avandalen/PCB-Spotwelder-Controller/README.md

This advanced controller was used by many people and has a unique reduced inrush current circuit that prevents main fuse blow up. This product is no longer for sale since 7-2020. 
See the article here: https://www.avdweb.nl/popular/spotwelder/spot-welder-controller-with-tft-display
