avandalen/PCB-Spotwelder-Controller/UPC v4.brd

## EAGLE design UPC v4.brd (2020-08-19, last stored version)

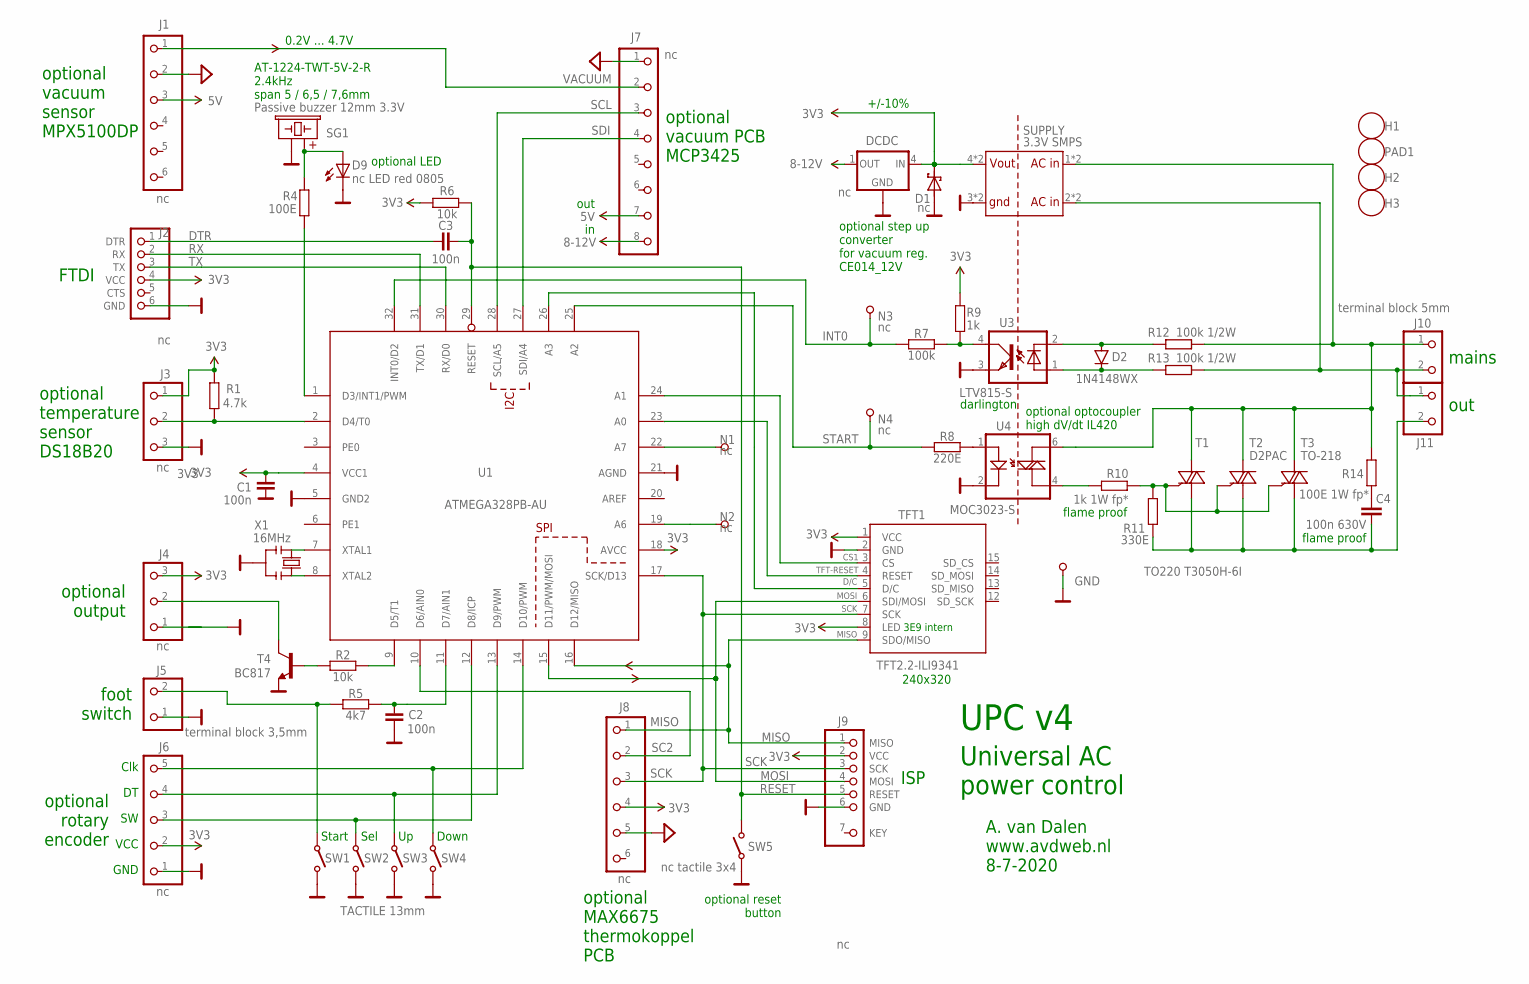
[picture p1: schematic UPC v4.sch]

Parts:
C1, C2, C3: 100n; 0603-SMALL
C4: 100n 630V; C15B6
D1: nc; DO-214AC
D2: 1N4148WX; SOD-323
D9: nc LED red 0805; CHIP-LED0805
DCDC: nc; 1X04-ACDC
GND: GND; PIN
H1, H2, H3: HOLE3.6; HOLE-3.6MM
J1: nc; MPX5100-VACUUM-SENSOR
J2: nc; ZIGZAG-FTDI
J3, J4: nc; 1X03
J5: terminal block 3,5mm; SCREWTERMINAL-3.5MM-2
J6: nc; 1X05
J7: nc; 1X08
J8: nc; 1X06-ISP-BOARD
J9: nc; ZIGZAG-ISP
J10: Terminal block 5mm 2p; SCREWTERMINAL-5MM-2
J11: terminal block 5mm; SCREWTERMINAL-5MM-2
N1, N2, N3, N4: nc; PIN-1.2MM
PAD1: HOLE3.6; HOLE-3.6MM
R1: 4.7k; 0603-SMALL
R2, R6: 10k; 0603-SMALL
R4: 100E; 0603-SMALL
R5: 4k7; 0603-SMALL
R7: 100k; 0603-SMALL
R8: 220E; 0603-SMALL
R9: 1k; 0603-SMALL
R10: 1k 1W fp*; 0411/15_AVD
R11: 330E; 0603-SMALL
R12, R13: 100k 1/2W; M1206
R14: 100E 1W fp*; 0411/15_AVD
SG1: Passive buzzer 12mm 3.3V; BUZZER-12MM-NS-KIT
SUPPLY: 3.3V SMPS; SMPS2
SW1, SW2, SW3, SW4: TACTILE 13mm; TACTILE-PTH
SW5: nc tactile 3x4; TACTILE-3X4
T1: TO220 T3050H-6I; TO220-SPOTWELDER
T2: D2PAC; D2PACK-SPOTWELDER-NO-CREAM
T3: TO-218; TO218-SPOTWELDER
T4: BC817; SOT23-3
TFT1: TFT2.2-ILI9341; TFT2.2-9P
U1: ATMEGA328PB-AU; TQFP32-08
U3: LTV815-S; DIL4-SMD
U4: MOC3023-S; DIL6-SMD-WIDE
X1: 16MHz; RESONATOR

Connections:
3V3: C1.2, D1.C, DCDC.4 (IN), J2.4 (VCC), J3.1, J4.3, J6.2, J8.4, J9.2 (VCC), R1.1, R6.2, R9.2, SUPPLY.4 (5V), SUPPLY.7 (5V), TFT1.1 (VCC), TFT1.8 (LED), U1.4 (VCC1), U1.18 (AVCC)
5V: J1.3, J7.7
8-12V: DCDC.1 (OUT), J7.8
AGND: J1.2, J7.1, J8.5
BUZZER: R4.2, U1.1 (D3/INT1/PWM)
BUZZER+: D9.A, R4.1, SG1.+1 (+), SG1.+2 (+)
CS1: TFT1.3 (CS), U1.24 (A1)
D/C: TFT1.5 (D/C), U1.26 (A3)
DOWN: J6.3, SW2.3, SW2.4, U1.12 (D8/ICP)
DTR: C3.1, J2.1 (DTR)
FOOT1: J5.2, R5.1, SW1.3, SW1.4
FOOT2: C2.2, R5.2, U1.11 (D7/AIN1)
GND: C1.1, C2.1, D1.A, D9.C, DCDC.2 (GND), DCDC.3 (GND), GND.1, J2.6 (GND), J3.3, J4.1, J5.1, J6.1, J9.6 (GND), SG1.-1 (-), SG1.-2 (-), SUPPLY.3 (GND), SUPPLY.5 (GND), SW1.1 (O), SW1.2 (O), SW2.1 (O), SW2.2 (O), SW3.1 (O), SW3.2 (O), SW4.1 (O), SW4.2 (O), SW5.2, T4.2 (E), TFT1.2 (GND), U1.5 (GND2), U1.21 (AGND), U3.3 (EMIT), U4.2, X1.2
INT0: N3.1, R7.1, U1.32 (INT0/D2)
MAINS1: J10.2, J11.1, R13.2, SUPPLY.2 (AC2), SUPPLY.8 (AC2)
MAINS2: J10.1, R12.2, R14.2, SUPPLY.1 (AC1), SUPPLY.9 (AC1), T1.2 (A2), T2.TAB (A2), T3.2 (A2), U4.6
MISO: J8.1, J9.1 (MISO), TFT1.9 (SDO/MISO), U1.16 (D12/MISO)
MOSI: J9.4 (MOSI), TFT1.6 (SDI/MOSI), U1.15 (D11/PWM/MOSI)
unnamed: R10.1, U4.4
unnamed: R2.1, T4.1 (B)
unnamed: N2.1, U1.19 (A6)
unnamed: N1.1, U1.22 (A7)
unnamed: R8.2, U4.1
unnamed: D2.A, R12.1, U3.2 (C)
unnamed: D2.C, R13.1, U3.1 (A)
unnamed: U1.7 (XTAL1), X1.1
unnamed: C4.1, R14.1
unnamed: J4.2, T4.3 (C)
unnamed: R2.2, U1.9 (D5/T1)
unnamed: R7.2, R9.1, U3.4 (COL)
unnamed: U1.8 (XTAL2), X1.3
Q1-C: C4.2, C4.3 (2), J11.2, R11.1, T1.1 (A1), T2.1 (A1), T3.1 (A1)
Q1-G: R10.2, R11.2, T1.3 (G), T2.3 (G), T3.3 (G)
RESET: C3.2, J9.5 (RESET), R6.1, SW5.1 (O), U1.29 (RESET)
RX: J2.2 (RX), U1.31 (TX/D1)
SC2: J8.2, U1.10 (D6/AIN0)
SCK: J8.3, J9.3 (SCK), TFT1.7 (SCK), U1.17 (SCK/D13)
SCL: J7.3, U1.28 (SCL/A5)
SDI: J7.4, U1.27 (SDI/A4)
SEL: J6.5, SW4.3, SW4.4, U1.14 (D10/PWM)
START: N4.1, R8.1, U1.25 (A2)
TEMP: J3.2, R1.2, U1.2 (D4/T0)
TFT-RESET: TFT1.4 (RESET), U1.23 (A0)
TX: J2.3 (TX), U1.30 (RX/D0)
UP: J6.4, SW3.3, SW3.4, U1.13 (D9/PWM)
VACUUM: J1.1, J7.2

Notes on the sheet:
mains
out
foot switch
Universal AC power control
Start
Sel
Down
flame proof
240x320
A. van Dalen www.avdweb.nl 8-7-2020
3E9 intern
ISP
optional optocoupler high dV/dt IL420
optional vacuum sensor MPX5100DP
optional vacuum PCB MCP3425
optional temperature sensor DS18B20
+/-10%
optional step up converter for vacuum reg. CE014_12V
optional MAX6675 thermokoppel PCB
optional reset button
AT-1224-TWT-5V-2-R 2.4kHz span 5 / 6,5 / 7,6mm
optional rotary encoder
Clk
VCC
GND
FTDI
optional output
optional LED
UPC v4
darlington
0.2V ... 4.7V

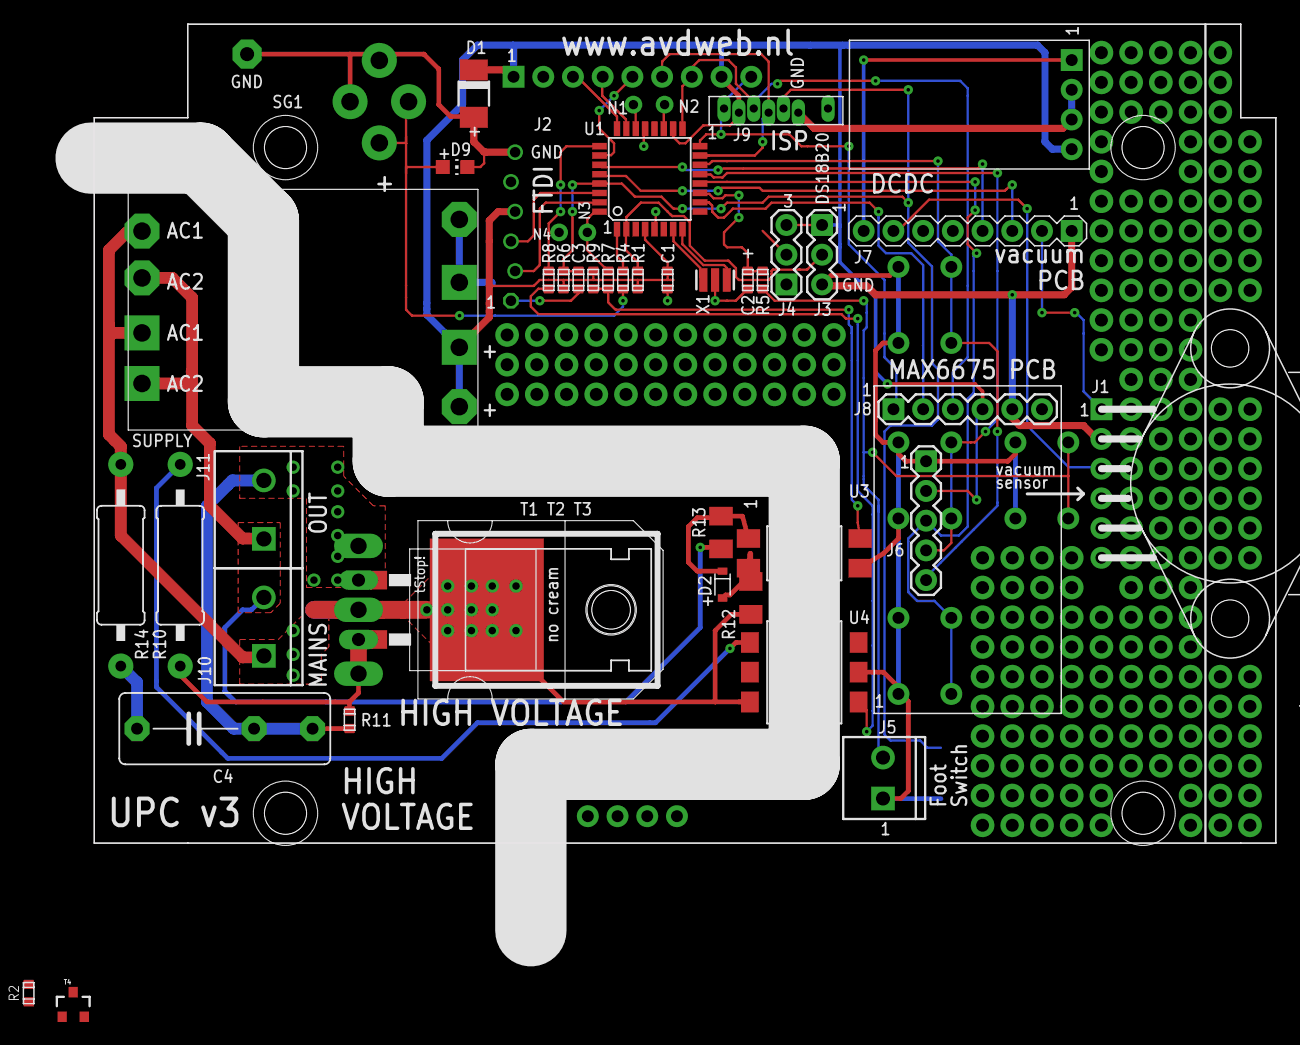
[picture p2: board UPC v4.brd from above]

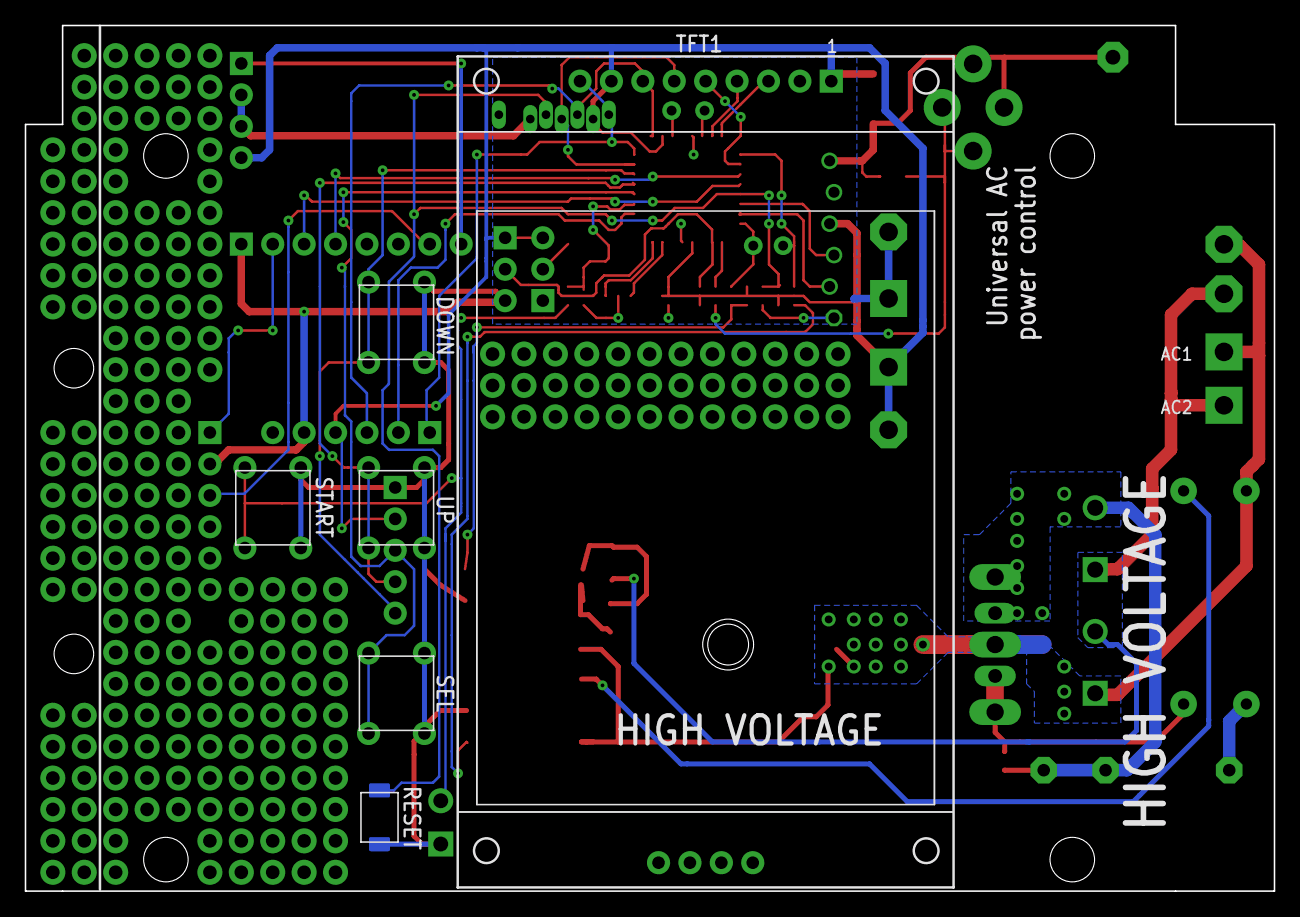
[picture p3: board UPC v4.brd from below]

Board: 2 copper layers, 101.0 x 70.0 mm, 57 parts (6 on the bottom side), 46 nets.
